SeeedDocument/Arch_Max/img/Get_started_with_mbed.png

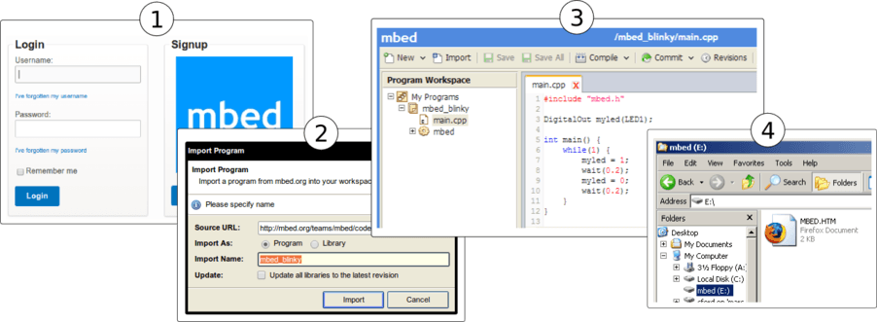
img/Get_started_with_mbed.png
