SeeedDocument/Arch_Max/res/Arch Max.pdf

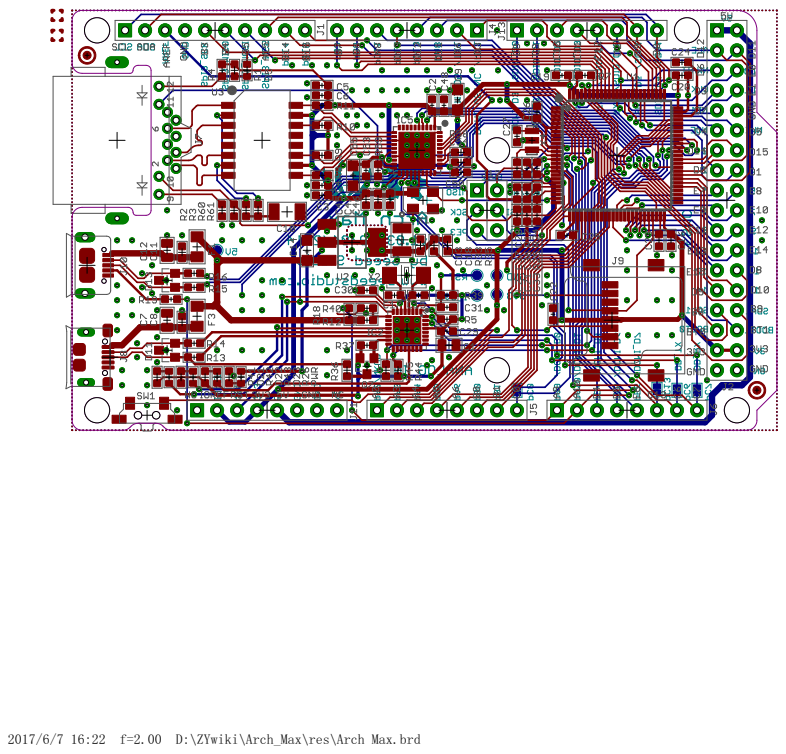
[picture p2: page 1]

2017/6/7 16:22 f=2.00 D:\ZYwiki\Arch_Max\res\Arch Max.brd
