SeeedDocument/Arch_Max/res/Arch_Max.pdf

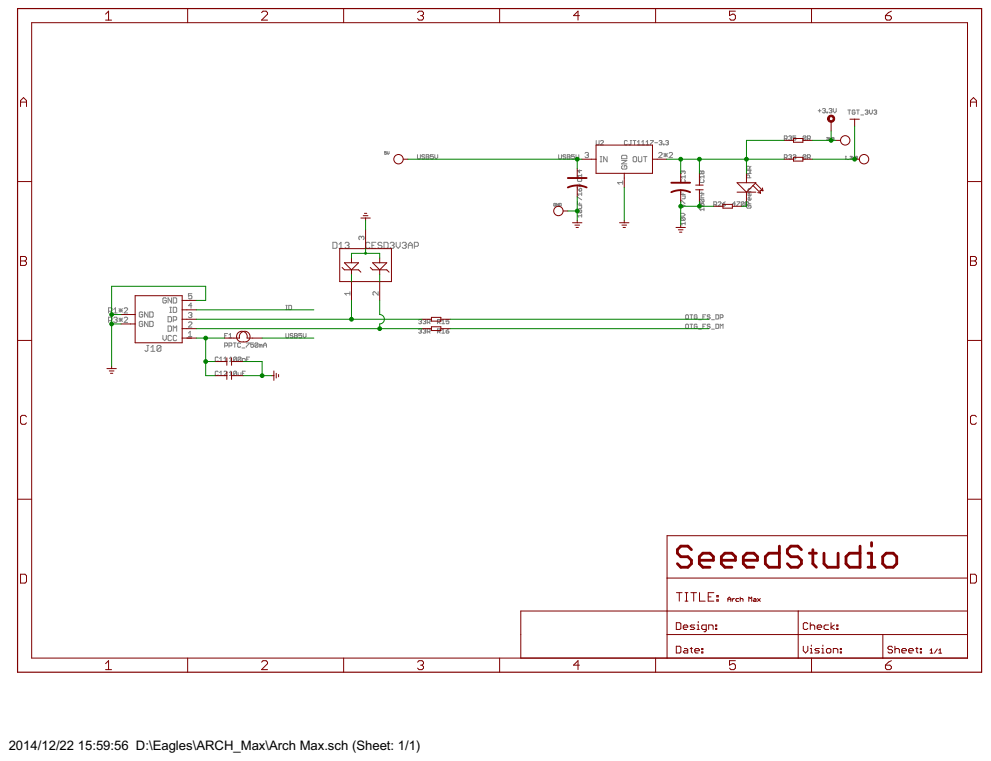
[picture p3: page 1]

2014/12/22 15:59:56 D:\Eagles\ARCH_Max\Arch Max.sch (Sheet: 1/1)

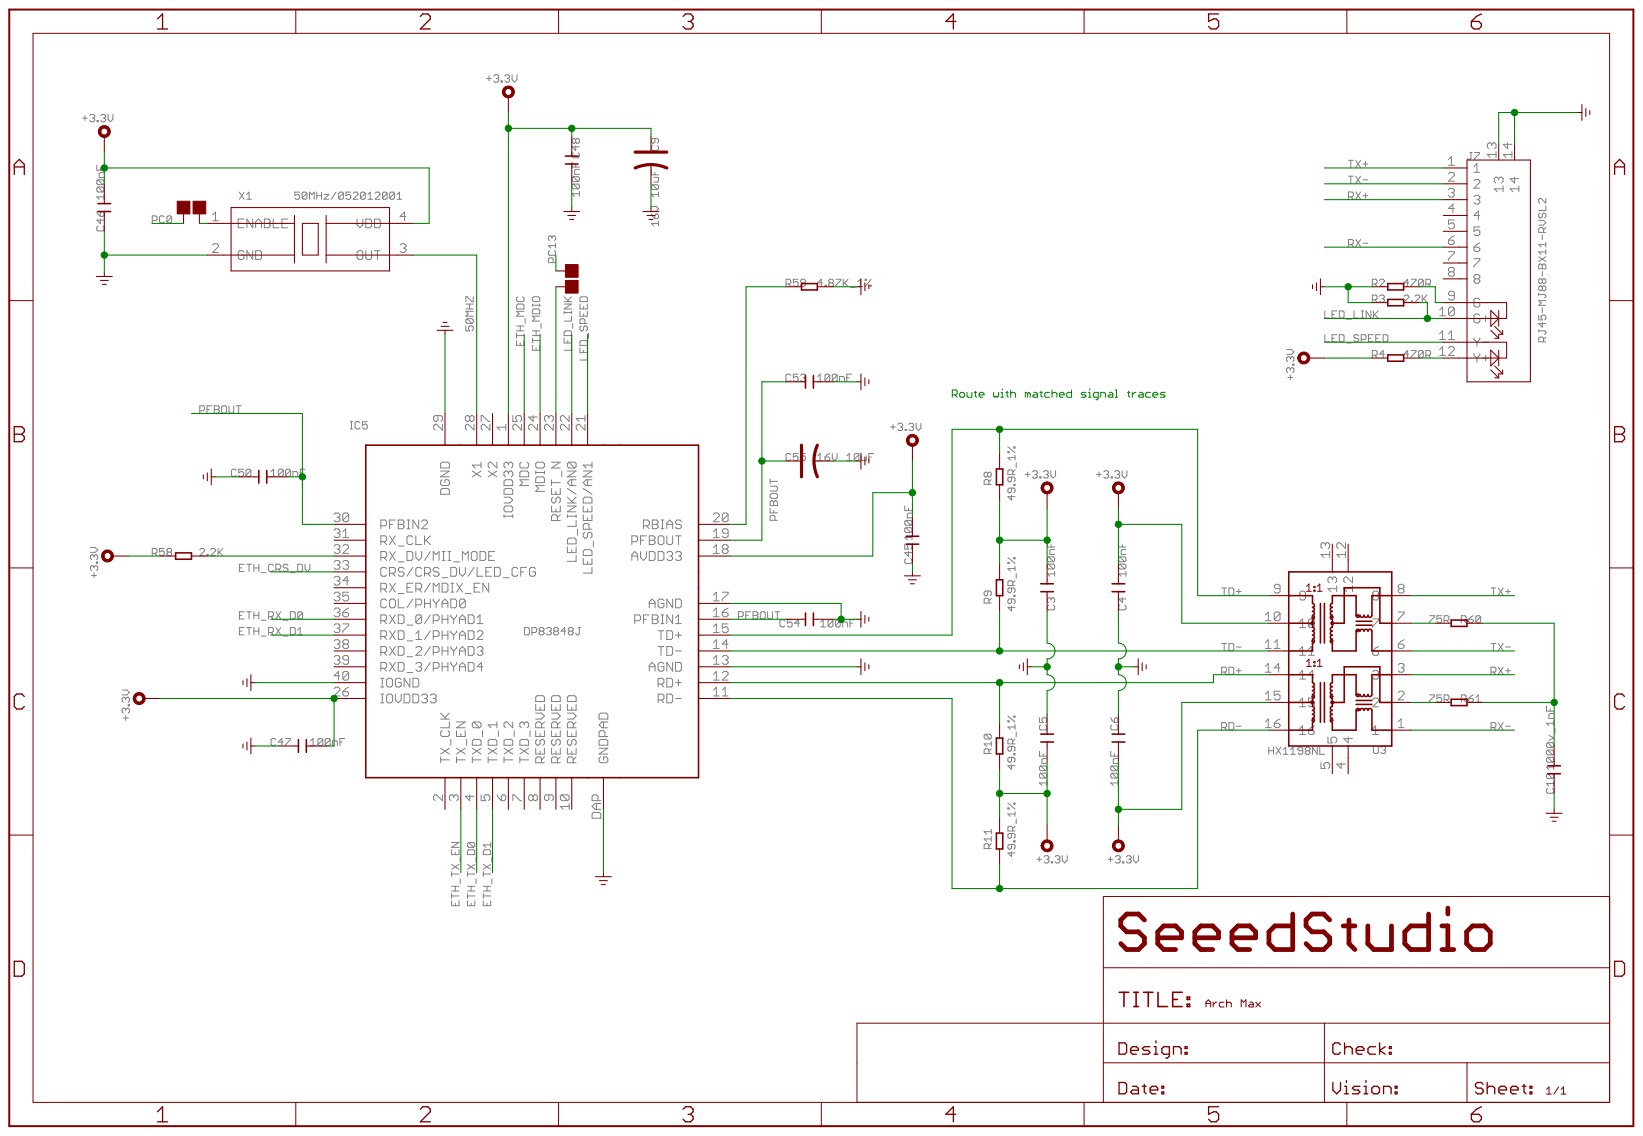
[picture p4: page 2]

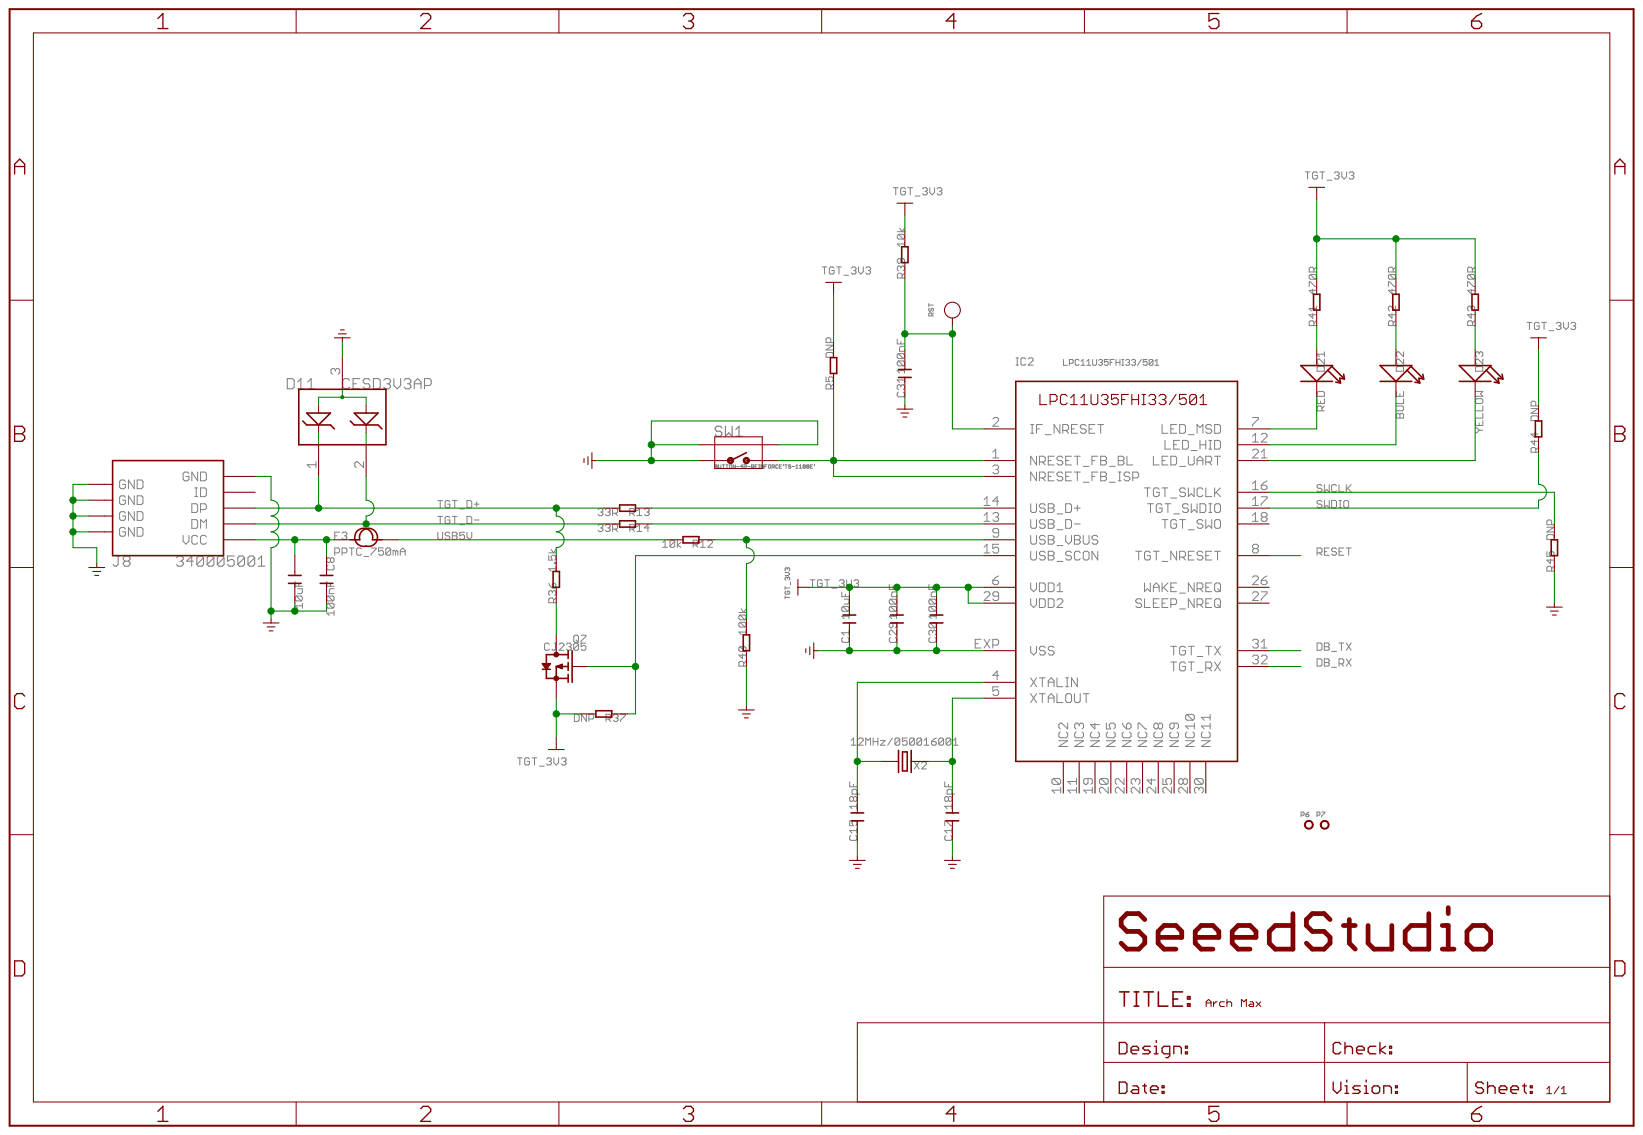
[picture p5: page 4]

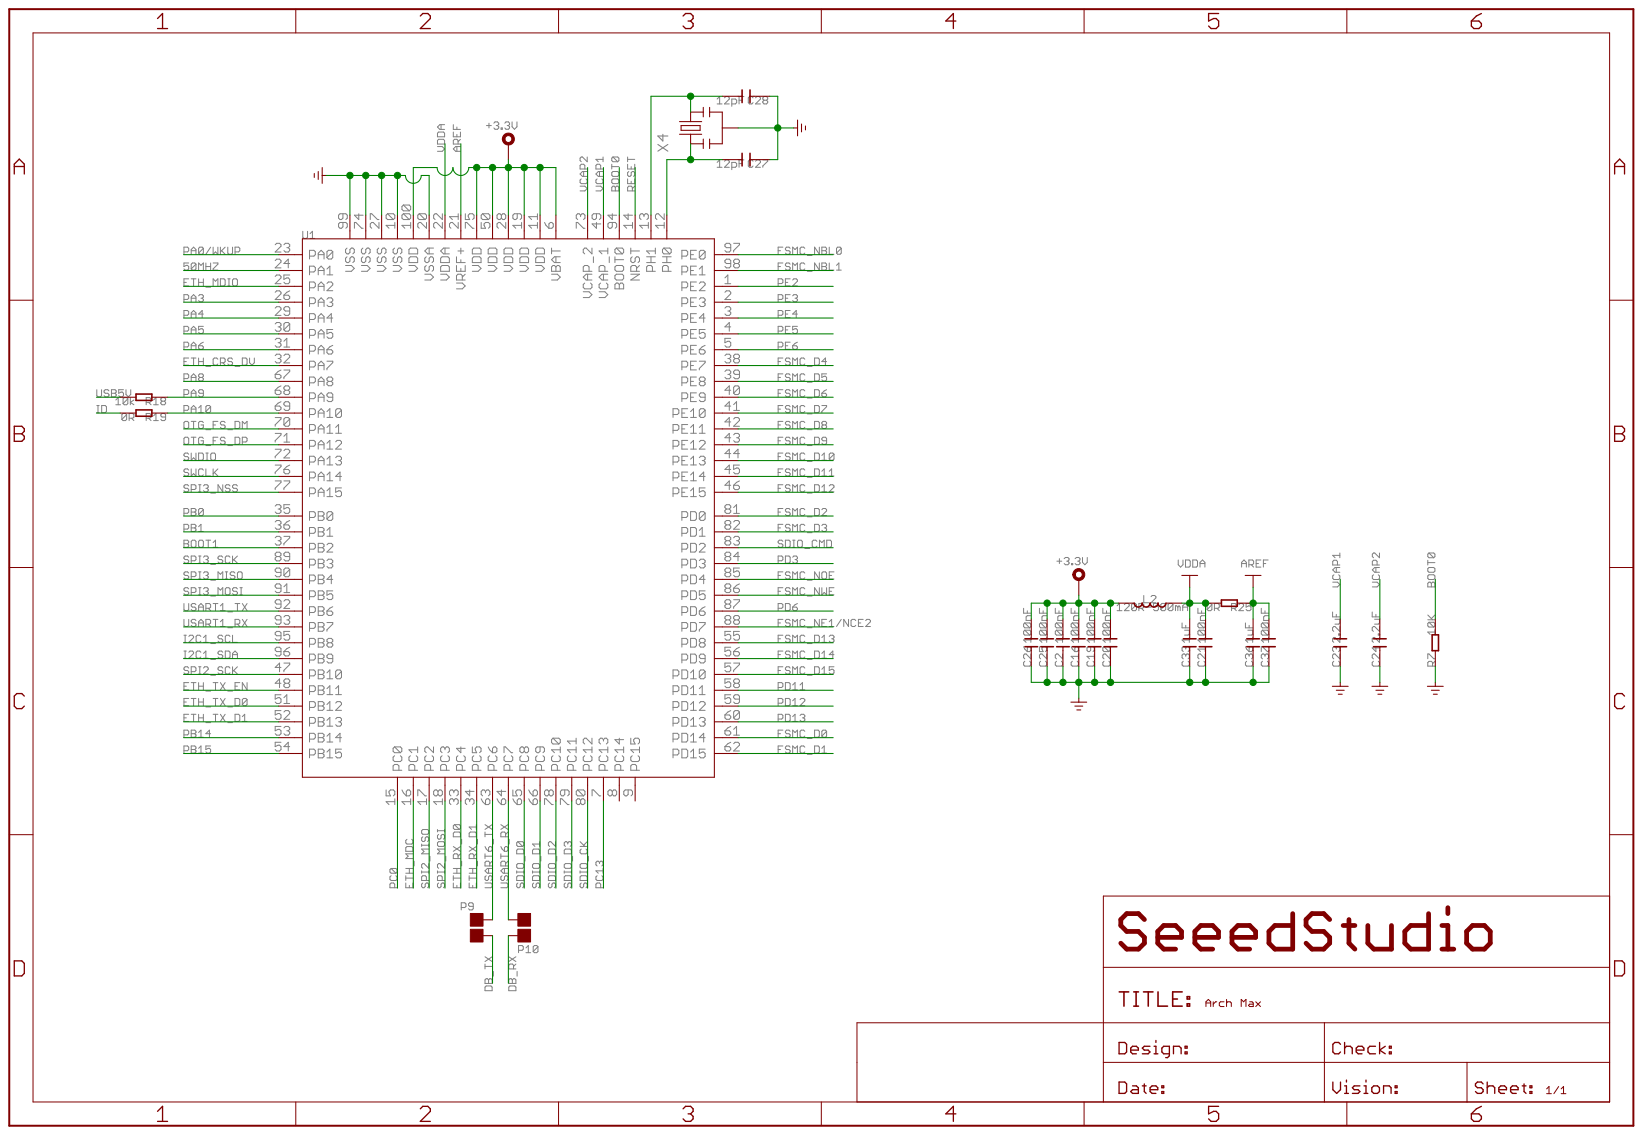
[picture p6: page 5]

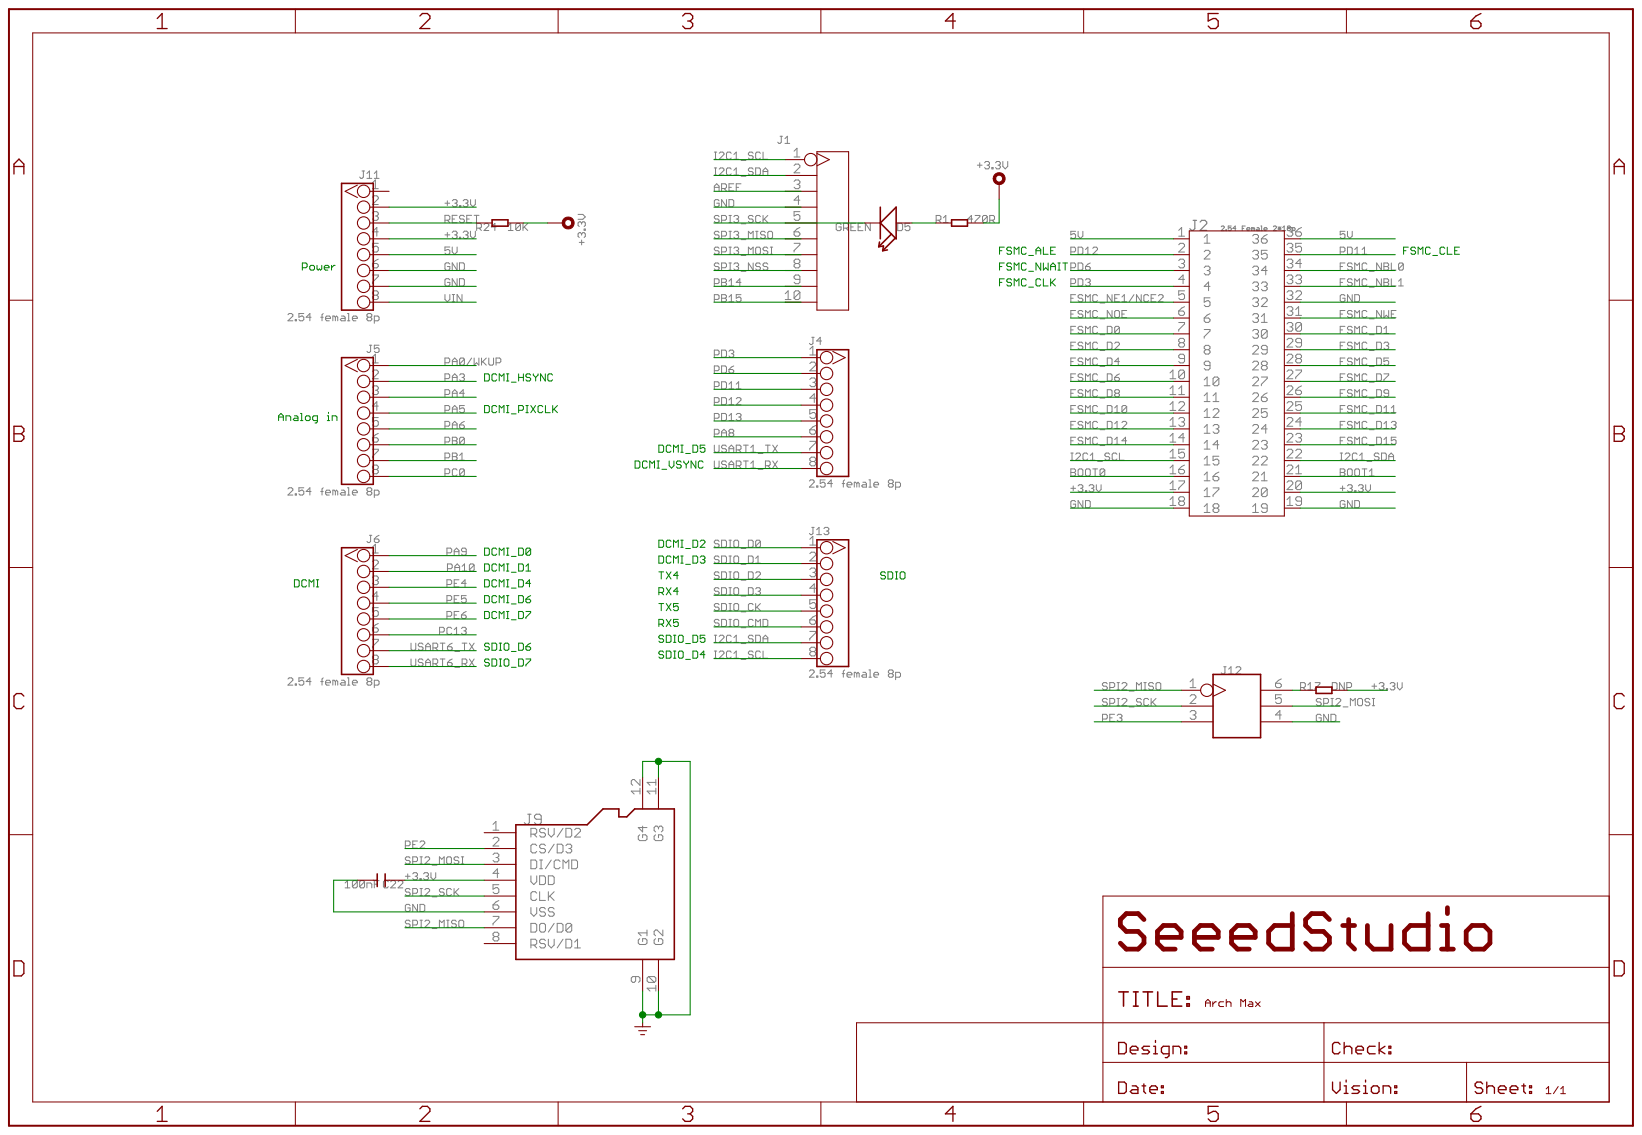
[picture p7: page 6]
